Toskine/boxity/One drive/Projet Objet connecté/IMG20220106124546.jpg

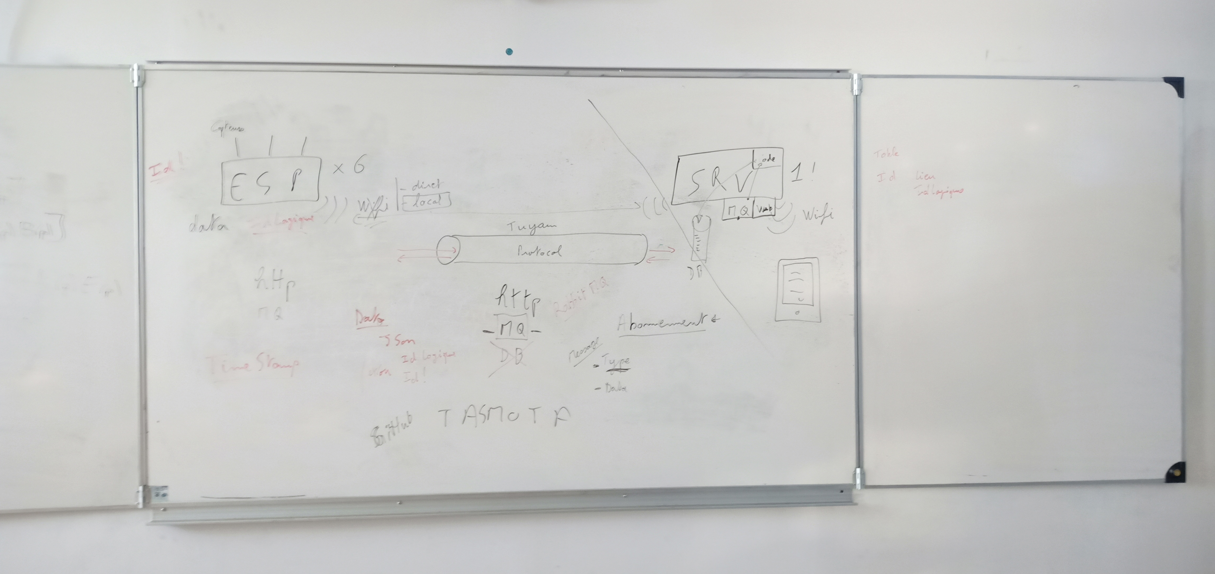
One drive/Projet Objet connecté/IMG20220106124546.jpg
