Toskine/boxity/READ_me.txt

Nos dossiers sont les suivants :

- OneDrive : contient toute nos recherches concernant le projet : étude énergitque, choix composants, lecture des capteurs....
- ADIAIRMOOD : django
- ADI_AirMood : code de l'objet (ESP)
- subscribes.py : python afin d'enregistrer dans la base de donnée
- cahier des charges
