Toskine/boxity/One drive/Projet Objet connecté/1-recherche/choix des composants/0-choix composants.pdf

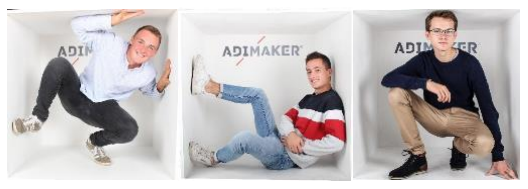
[picture p4: figure]

# OBJET CONNECTE : CHOIX COMPOSANTS HARDWARE

Mission | .
- Déterminer les composants par catégorie :
- Capteurs
- Interface utilisateur
- Alimentation électrique
Capteurs | .

Voici la liste des capteurs que nous allons utiliser :

Capteur | DHT 11 | Température et humidité
| TSL 2561 | Lumière
| BMP 180 | Pression
| MQ 135 | Gaz (qualité de l’air)
| MAX 4466 | Micro
Nous possédons déjà ces composants. (sauf le MQ 135 et le BMP 180)
Interface utilisateur | .

Ci-dessous un tableau présentant les composants nécessaires à l’interface utilisateur de la borne :

Interface utilisateur | Déjà fourni | Ecran OLED
| | Ruban LEDS I2C

Nous possédons déjà ces composants.

Alimentation électrique | .

De gros calculs ont été réalisés. Vous pouvez lire le document « Choix des composants alimentation » pour plus de précision. En voici la conclusion :

En conclusion, plusieurs choses qui influencent le choix des composants ont été déterminées :

- La surface minimale conseillée du panneau solaire est de 145 cm²
- La capacité conseillée de la batterie est de 2000 mAh (flexible de 30%)

Dans quelles mesures l’autonomie est garantie ?
- Le panneau est orienté plein sud (+ou- 15°)
- Le panneau est incliné de 14° par rapport à la verticale (+ou- 15°)
- Les rayons lumineux ne sont pas trop ou trop longtemps bloqués

Commentaire :
Des mesures ont été prises pour que l’Energie reçue soit suffisante. Mais il n’est pas exclu qu’une météo mauvaise durant longtemps amène la batterie vers une décharge totale.

SIMON WAVRANT BAPTISTE BODIN & ROBIN LECOUFFE

Composants choisis :

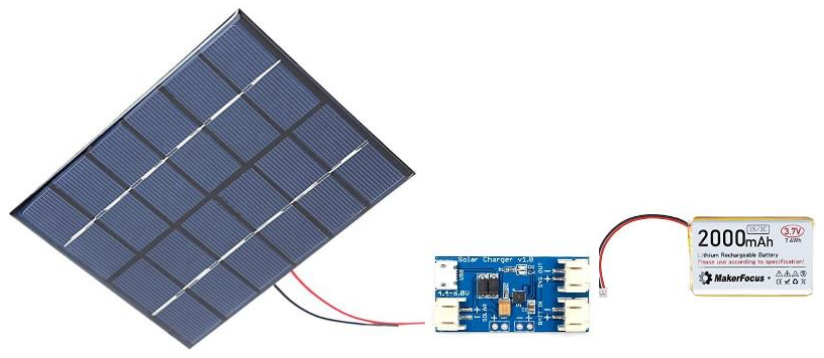
[picture p5: figure]

Tous ces composants sont à acheter.

Où acheter ? | .

Pour des raisons de rapidité et de fiabilité sur les livraisons, nous avons décidé de passer commande sur Amazon. Cependant, certains composants essentiels ne sont pas disponibles sur Amazon. Nous avons donc créé un panier sur le site Mouser.fr. Celui-ci est spécialisé dans les composants électroniques. Ajoutons l’achat de PLA pour notre boite sur le site de Wahnaofrance.com

Conclusion | .

Nous avons réalisé un panier sur Amazon. Nous en aurions pour 182,4 € pour les 6 groupes soit 30,4 € par groupe.

description | où acheter | info utile
Panneau | lien (https://www.amazon.fr/gp/product/B07CPPRFJT/ref=ox_sc_act_title_1?smid=A3OREX2CY7D0RU&psc=1) | 150 cm²
Chargeur | lien (https://www.amazon.fr/gp/product/B08TM6D7F9/ref=ewc_pr_img_4?smid=A210ZC6COC4ELF&psc=1)
régulateur | lien (https://www.mouser.fr/ProductDetail/Texas-Instruments/LP38500TJ-ADJ-NOPB?qs=1FNqv8aZn1TLohU8KozYqA%3D%3D) | 3-4.2-> 3.3v
batterie | lien (https://www.amazon.fr/gp/product/B08TQSC5G9/ref=ox_sc_act_title_3?smid=A1QGN06QN25C35&psc=1) | 2000mAh
