Toskine/boxity/One drive/Projet Objet connecté/1-recherche/model 3D des composants/read me.txt

il manque :
panneau solaire
batterie

et c tout
