Toskine/boxity/One drive/Projet Objet connecté/1-recherche/choix des composants/2-liste final.ods

composants | groupe | nombre | lien | nombre de pièce dans le lot | prix du lot | prix total | rab de pièces
panneau solaire 6v 2W | EF | 2 | amazon (https://www.amazon.fr/gp/product/B07CPPRFJT/ref=ox_sc_act_title_1?smid=A3OREX2CY7D0RU&psc=1) | 1 | 10,99 | 21,98 | X
régulateur de tension LDO | F | 1 | amazon (https://www.amazon.fr/AZDelivery-AMS1117-dalimentation-Arduino-Raspberry/dp/B07VGNPP7N) | 1 | 6,79 | 6,79 | 4
MQ 135 | ABCDEF | 6 | amazon (https://www.amazon.fr/ZHITING-capteurs-qualit%C3%A9-d%C3%A9tection-dangereux/dp/B08B3HRRVV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) | 3 | 8,99 | 17,98 | X
MQ 9 | ABEF | 4 | amazon (https://www.amazon.fr/HUABAN-MQ-9-inflammable-d%C3%A9marrage-bricolage/dp/B089SQ22S6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) | 2 | 9 | 18 | X
BMP 180 | ABCDEF | 6 | amazon (https://www.amazon.fr/AZDelivery-Barometric-Temperature-daltitude-Raspberry/dp/B07HMR871C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) | 5 | 7,89 | 15,78 | 4
DHT 22 | DFCE | 4 | amazon (https://www.amazon.fr/AZDelivery-capteur-dhumidit%C3%A9-temp%C3%A9rature-Raspberry/dp/B074MY32RX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) | 5 | 31,99 | 31,99 | 1
LI 18650 3000mAh | ABCDE | 3 + x3 + x3 = 9 | amazon (https://www.amazon.fr/Sony-VTC6-3000-AMAVAPE-Nicotine-Tabac/dp/B08X1KTZ4K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) | 2 | 8,8 | 44 | 1
MPC23017 | A | 1 | amazon (https://www.amazon.fr/dp/B07P2KD39X/ref=cm_sw_r_awdo_navT_a_YP557MBXB8RYRJGYHV28) | 1 | 9,75 | 9,75 | X
chargeur 18650 | ABCDE | 5 | amazon (https://www.amazon.fr/dp/B09FT1MZFK) | 5 | 11,89 | 11,89 | X
ecran avec les boutons | E | 1 | amazon (https://www.amazon.fr/Waveshare-1-44inch-Interface-Direct-pluggable-Raspberry/dp/B077Z7DWW1?th=1) | 1 | 16,42 | 16,42 | X
lipo 2 Ah | F | 1 | amazon (https://www.amazon.fr/gp/product/B08TQSC5G9/ref=ox_sc_act_title_3?smid=A1QGN06QN25C35&psc=1) | 4 | 29,99 | 29,99 | 3
chargeur solaire | F | 1 | amazon (https://www.amazon.fr/gp/product/B08TM6D7F9/ref=ewc_pr_img_4?smid=A210ZC6COC4ELF&psc=1) | 1 | 4,75 | 4,75 | X
Support de Batterie | ABCDE | 3 + x3 + x3 = 9 | amazon (https://www.amazon.fr/GTIWUNG-Support-Batterie-Plastique-Rangement/dp/B08CY56M98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) | 12 | 10,99 | 10,99 | 3
Total |  |  |  |  |  | 240,31
chef de groupe | lettre du groupe | (Certains sont moins chers en prenant un lot de x composants que le composant seul) |  | J'ai vérifié avec tous les groupes la liste de tout ce qu'ils voulaient.
Sam | A
Antoine | B
Maël | C
Clément Z | D | Si problème de compréhension renvoyez moi un mail. |  | J'ai essayé de revoir tous les liens afin de trouver le meilleur prix en fonction du nombre de pièces, j'ai aussi fait en sorte que tout soit sur Amazon.
Clément V | E
Simon | F
