Toskine/boxity/One drive/Projet Objet connecté/1-recherche/model 3D des composants/DHT11.STEP

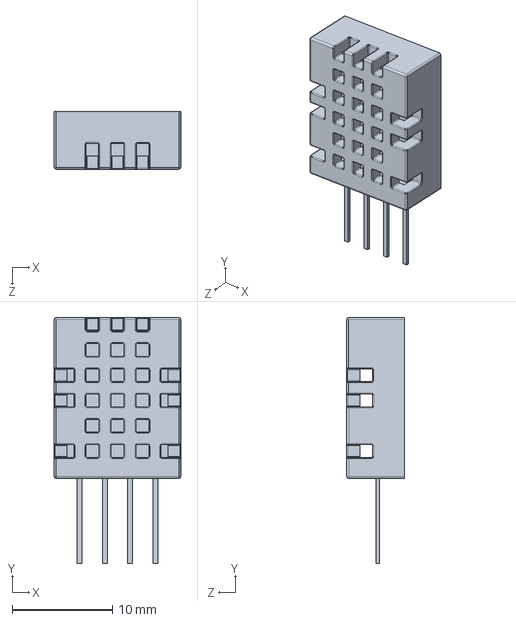
[picture p14: CAD file, 2025-05-06]
One drive/Projet Objet connecté/1-recherche/model 3D des composants/DHT11.STEP
12.7 x 24.6 x 5.75 mm
