Toskine/boxity/One drive/Projet Objet connecté/1-recherche/model 3D des composants/tsl2561.step

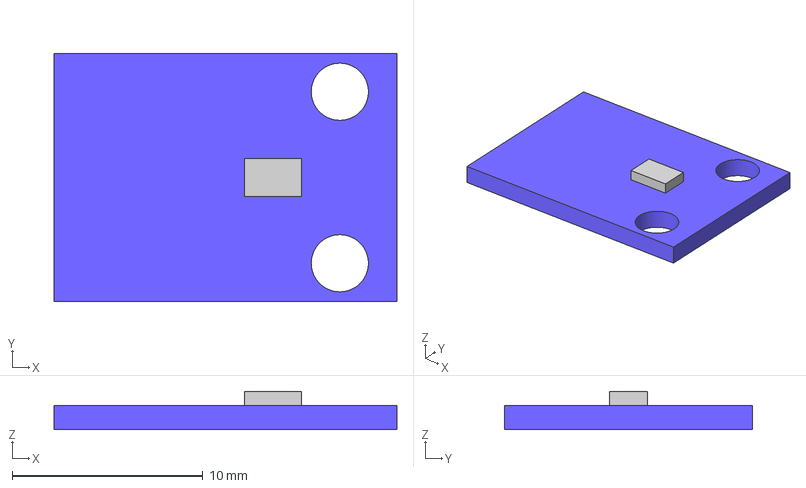
[picture p15: CAD file, 2025-05-06]
One drive/Projet Objet connecté/1-recherche/model 3D des composants/tsl2561.step
18.0 x 13.0 x 2.00 mm
