Toskine/boxity/One drive/Projet Objet connecté/1-recherche/model 3D des composants/ER-OLEDM0.96-1-I2C_3D.stp

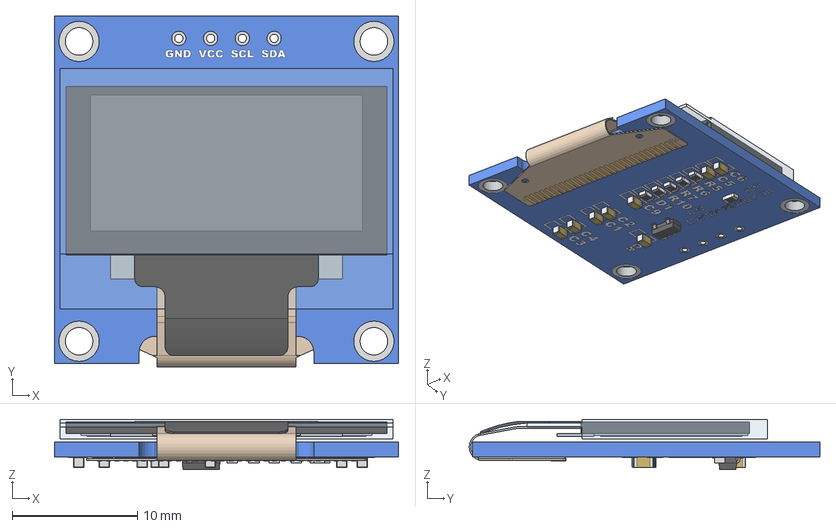
[picture p16: CAD file, 2025-05-06]
One drive/Projet Objet connecté/1-recherche/model 3D des composants/ER-OLEDM0.96-1-I2C_3D.stp
27.5 x 28.0 x 4.03 mm
0.96 OLED - Board - i2c
0.96 OLED - Glass
0.96 OLED - Flat Reverse
0603 Resistor x 6
SOT-23
0603 Capacitor x 8
