Toskine/boxity/One drive/Projet Objet connecté/1-recherche/model 3D des composants/CN3065 Solar Charger board.stp

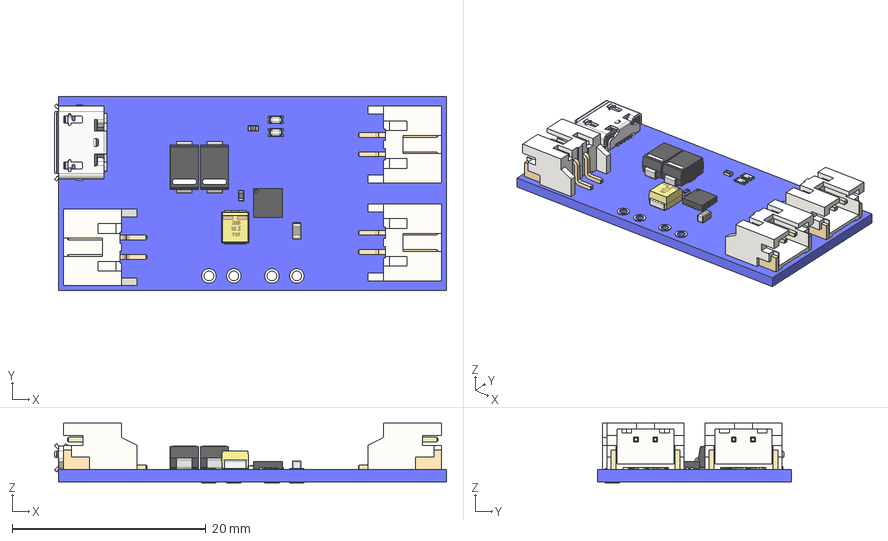
[picture p17: CAD file, 2025-05-06]
One drive/Projet Objet connecté/1-recherche/model 3D des composants/CN3065 Solar Charger board.stp
40.4 x 20.0 x 6.17 mm
board
micro USB
S2B-PH-SM4-TB x 3
Diode SMA x 2
Tant Cap SMD size B _ 3528-21
QFN-16 (3x3)
CAPC-0603-T0.9-BN
RESC-0402 x 2
0603 LED v7 x 2
hole_plating x 8
