Toskine/boxity/One drive/Projet Objet connecté/1-recherche/model 3D des composants/BMP180 Breakout.step

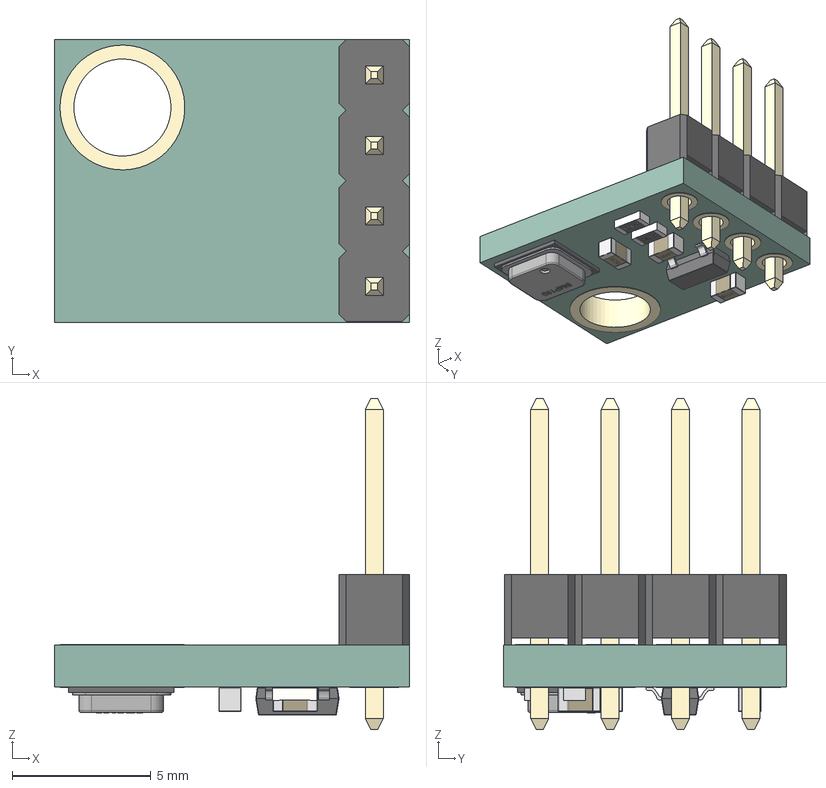
[picture p18: CAD file, 2025-05-06]
One drive/Projet Objet connecté/1-recherche/model 3D des composants/BMP180 Breakout.step
12.8 x 10.2 x 11.9 mm
r-smd-0603 x 2
c-smd-0603 x 3
PinHeader
SOT23SMD v1
BMP180
