Toskine/boxity/One drive/Projet Objet connecté/1-recherche/model 3D des composants/MQ-2.step

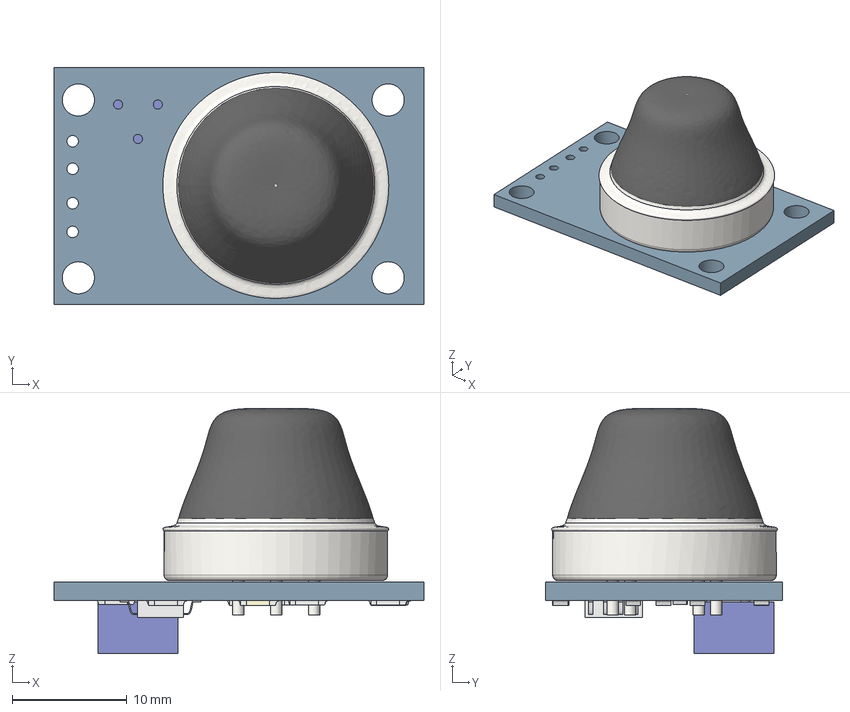
[picture p19: CAD file, 2025-05-06]
One drive/Projet Objet connecté/1-recherche/model 3D des composants/MQ-2.step
32.2 x 20.6 x 21.4 mm
PCB
sensor
10k ohm SMT x 7
leads
