Toskine/boxity/One drive/Projet Objet connecté/1-recherche/model 3D des composants/Max4466.STEP

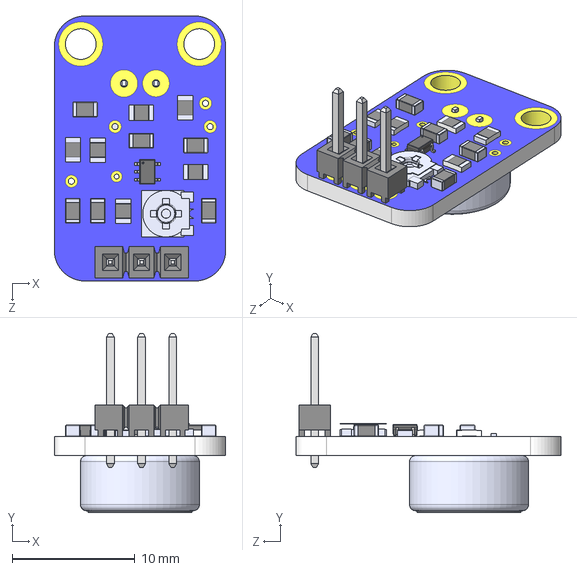
[picture p20: CAD file, 2025-05-06]
One drive/Projet Objet connecté/1-recherche/model 3D des composants/Max4466.STEP
14.0 x 14.6 x 21.6 mm
