Toskine/boxity/One drive/Projet Objet connecté/2-conception/Screen/test_screen.ino

/*
 * This is the main script, where the function is tested.
 */
 
void setup() {
  // put your setup code here, to run once:
  Serial.begin(115200);
  Screen_initialisation();

}

void loop() {
  // put your main code here, to run repeatedly:

}
