Toskine/boxity/(commit log)

2025-05-09 fix button_port
2025-05-13 ajout led
2025-05-13 print barometre
